stav98/UrsaRobotics_SmartHome/README.md

<H1><a href="https://stav98.github.io/UrsaRobotics/" target="_blank">Για φωτογραφίες με τα στάδια της κατασκευής, περιγραφή λειτουργίας, video και τεκμηρίωση, ακολουθήστε το Link ...</a></H1>

**Ομάδα:** Ursa Robotics<br/>
**Σχολείο:** 1ο ΕΠΑ.Λ. Πρέβεζας<br/>
**Τίτλος έργου:** Έξυπνο Σπίτι Ανοιχτών Τεχνολογιών<br/> 

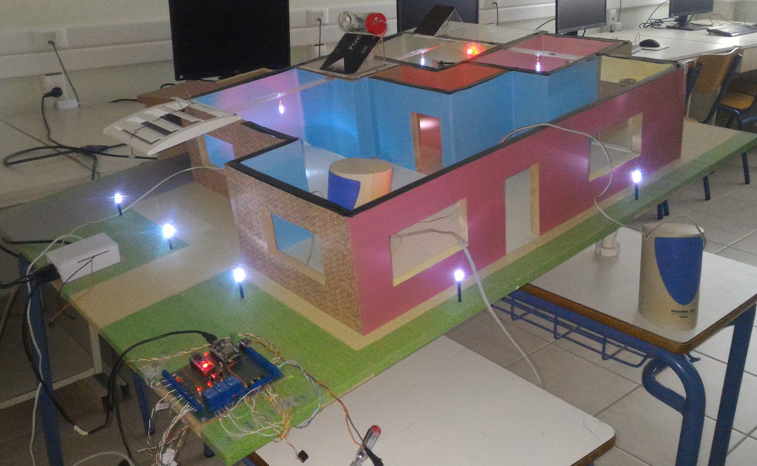
[picture p1: images/maketa_teliki.jpg]


<a href="https://www.youtube.com/embed/EgXMZQicLHs">Το video της τελικής παρουσίασης</a>

<a href="https://github.com/stav98/UrsaRobotics_SmartHome/blob/master/protasi-specs.md" target="_blank">Η αρχική πρόταση και οι προδιαγραφές πριν την υλοποίηση.</a>
