stav98/UrsaRobotics_SmartHome/hardware/README.md

Εδώ υπάρχουν τα θεωρητικά κυκλώματα καθώς και ο τρόπος συνδεσμολογίας των συσκευών στη μακέτα.
Τα σχέδια δημιουργήθηκαν με το KiCad 4.0.5.
