stav98/UrsaRobotics_SmartHome/arduino/README.md

Αυτός είναι ο κώδικας που ανεβαίνει στο Arduino Nano. Εμείς τον μεταγλωττίσαμε με το IDE 1.8.9 για Raspberry (ARM 32bit) και για Debian i386. Στις beta εκδόσεις 2.xx μεταγλωττίζεται με κάποιο λάθος και δεν λειτουργεί σωστά η απάντηση από τον slave 2 συνεχόμενων bytes.
Δεν απαιτείται κάποια extra βιβλιοθήκη.
