stav98/UrsaRobotics_SmartHome/node-red/src/README.md

Το αρχείο flow-dd-mm-yy.txt είναι αυτό που πρέπει να γίνει import στο Node-Red. Προσοχή απαιτείται εγκατάσταση του UI.
Ακόμη είναι σε πολύ απλή μορφή και πρόκειται να κάνουμε πολλές βελτιώσεις.

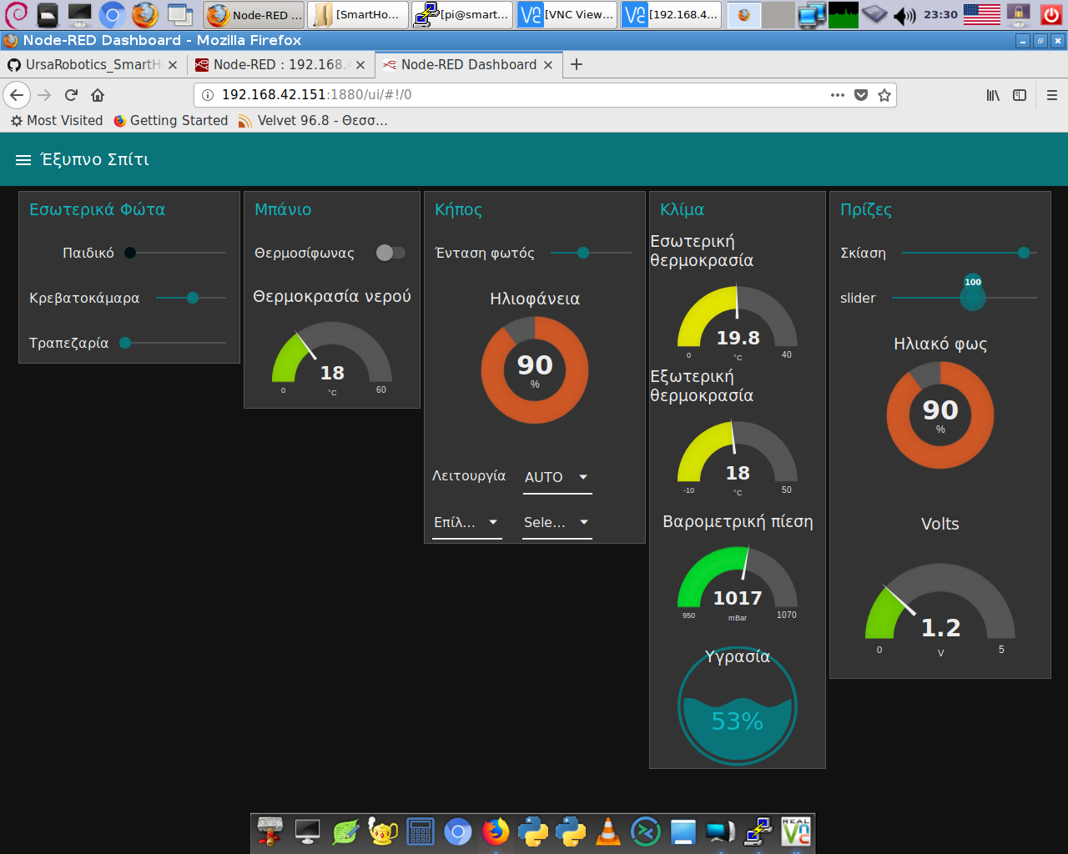
[picture p2: node-red/src/ui1.png]


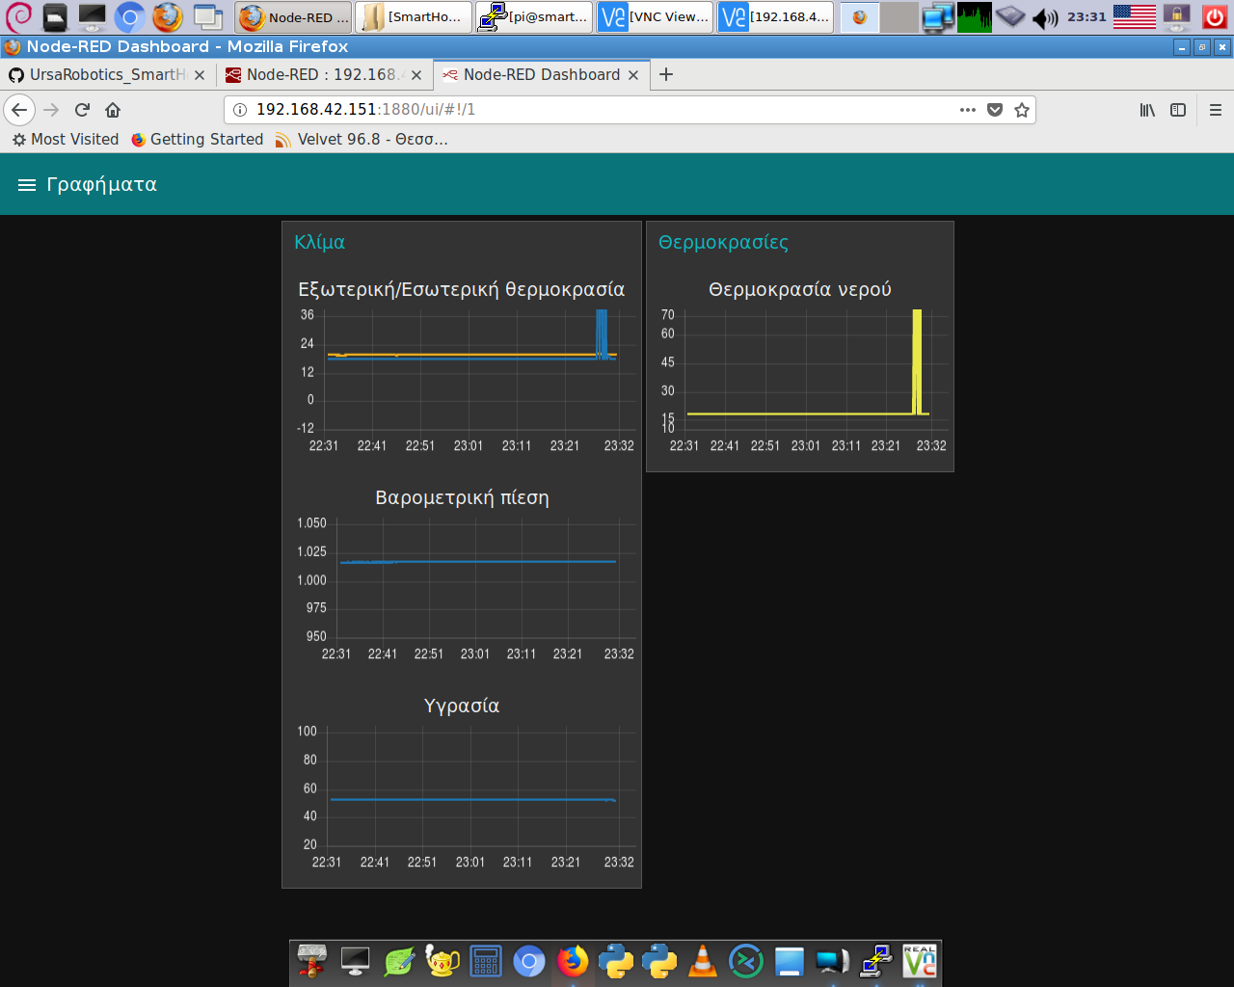
[picture p3: node-red/src/ui2.png]


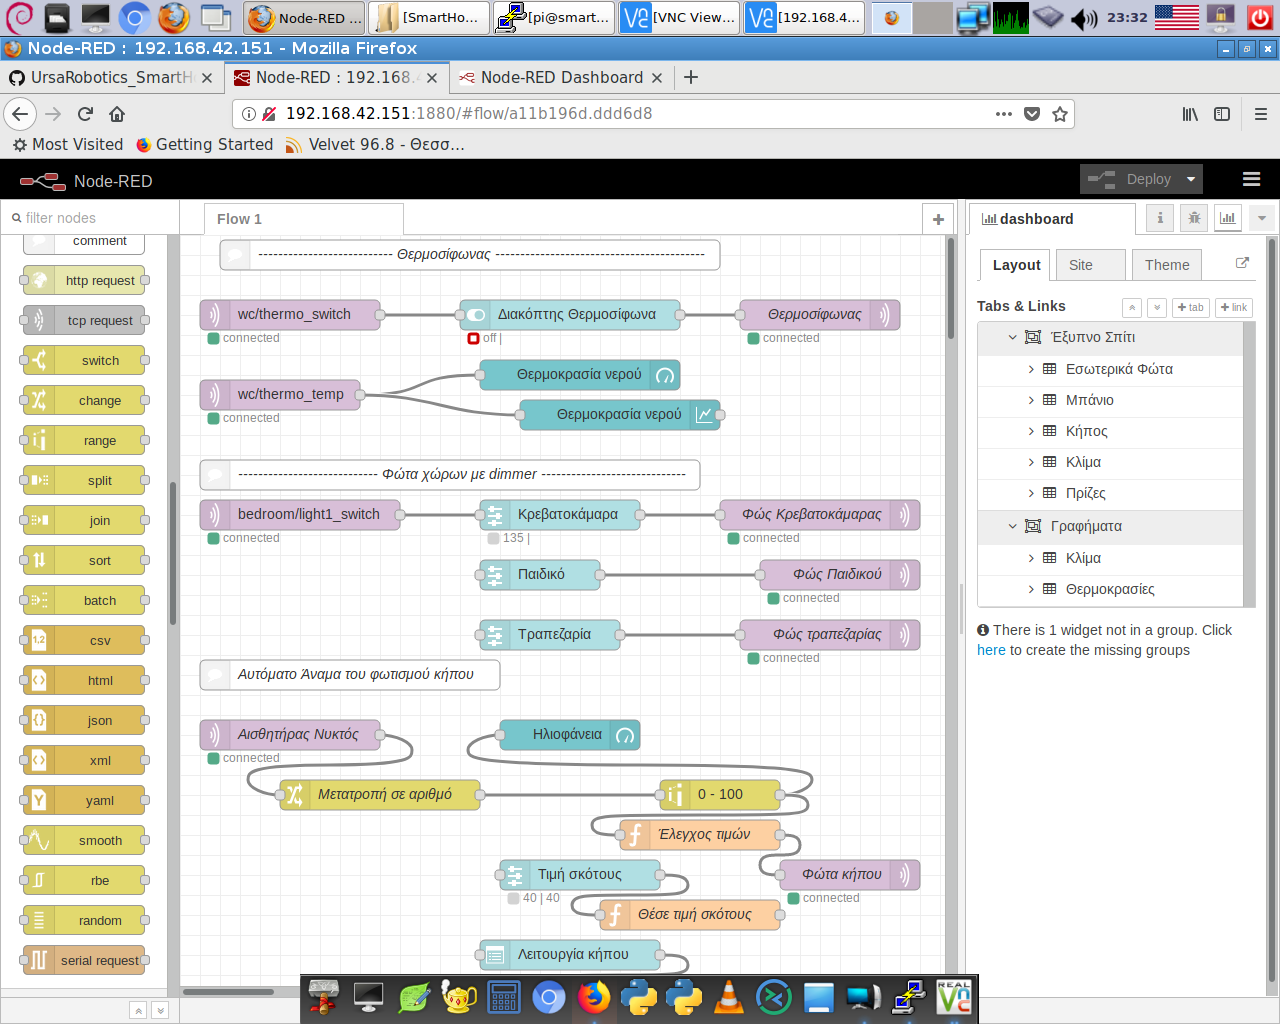
[picture p4: node-red/src/flow1.png]
