stav98/UrsaRobotics_SmartHome/Schematics.md

Το σχέδιο της μακέτας
=====================
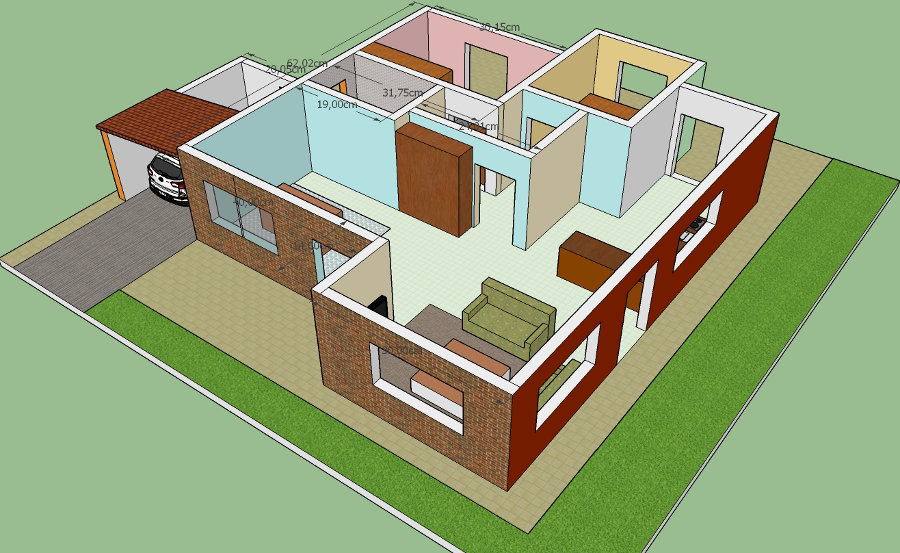
[picture p6: images/maketa_3d.jpg]


Οι θέσεις των εξαρτημάτων στη μακέτα
====================================
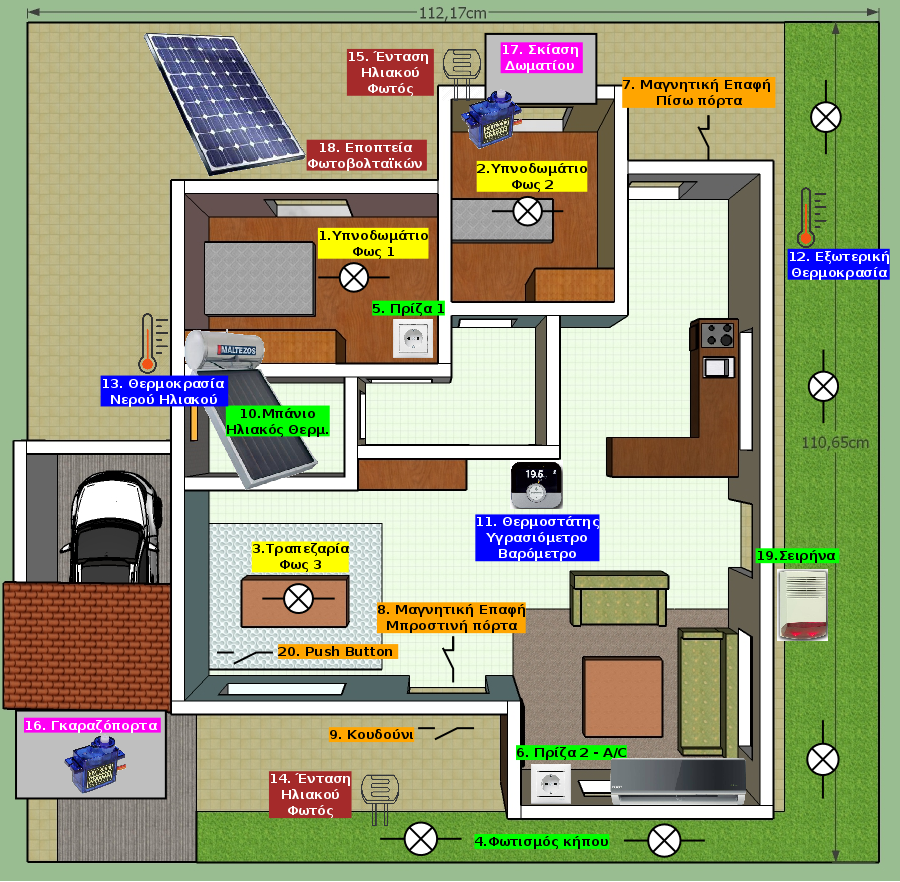
[picture p7: images/maketa_nodim_katopsi1.png]


Οι τύποι των σημάτων

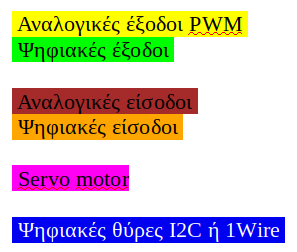
[picture p8: images/signal_types.png]


Συνδεσμολογία ακίδων στο Arduino mini

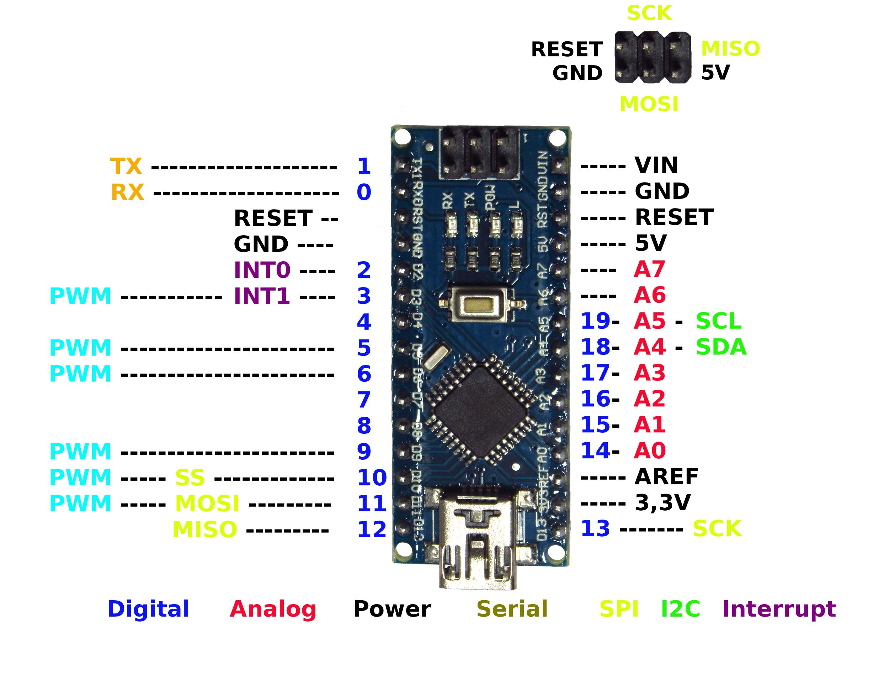
[picture p9: images/ArduinoNano_Pinout.jpg]


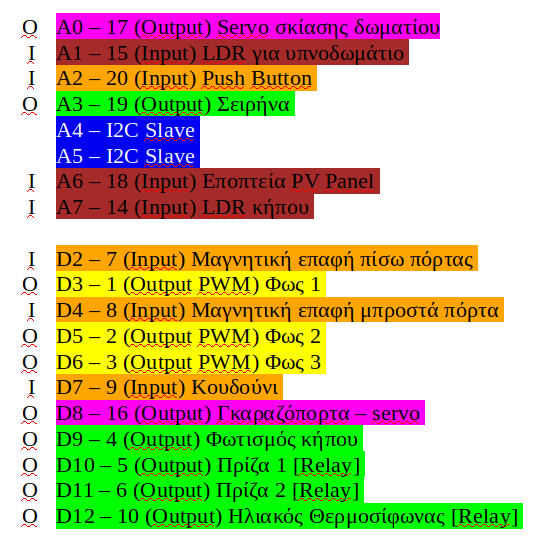
[picture p10: images/arduino_pin_connections.png]
