stav98/UrsaRobotics_SmartHome/documentation/README.md

Εδώ υπάρχουν έγγραφα όπως αρχεία περιγραφής, φύλλα εργασίας και παρουσιάσεις.

Τα διαγράμματα με επέκταση .xml έχουν δημιουργηθεί στο online σχεδιαστικό draw.io.

Στο αρχείο maketa-3d.zip υπάρχει το τρισδιάστατο μοντέλο της μακέτας φτιαγμένο σε Sketchup 2016.
