stav98/UrsaRobotics_SmartHome/python/README.md

Εδώ υπάρχει ο κώδικας για χρήση φωνητικών εντολών.
