stav98/UrsaRobotics_SmartHome/micropython/src/README.md

Τα αρχεία με επέκταση .py πρέπει να ανέβουν στο ESP8266 -  Node MCU. 
Το αρχείο upload το χρησιμοποιούμε για αυτοματοποιημένο Upload μέσα από το Geany (Raspbian) πατώντας Shift+F8.
