stav98/UrsaRobotics_SmartHome/documentation/software_interconnection.png

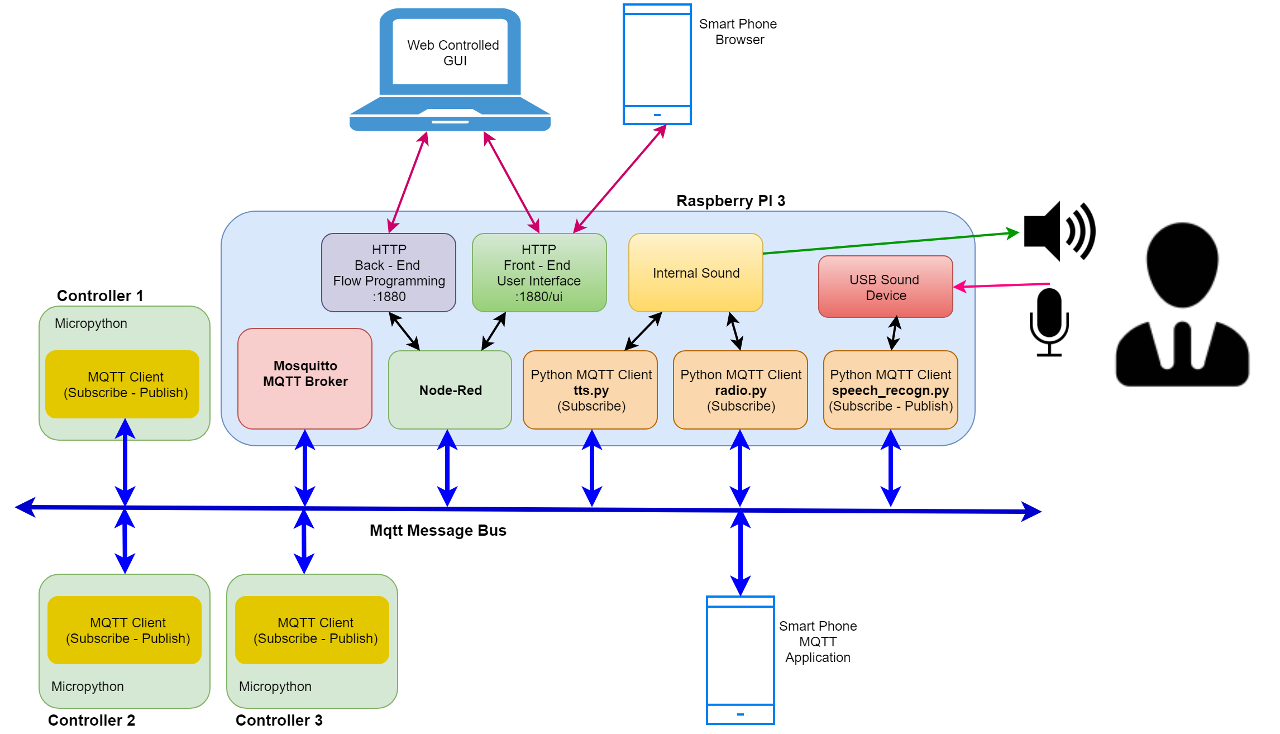
documentation/software_interconnection.png
