stav98/UrsaRobotics_SmartHome/hardware/controller_ports.jpg

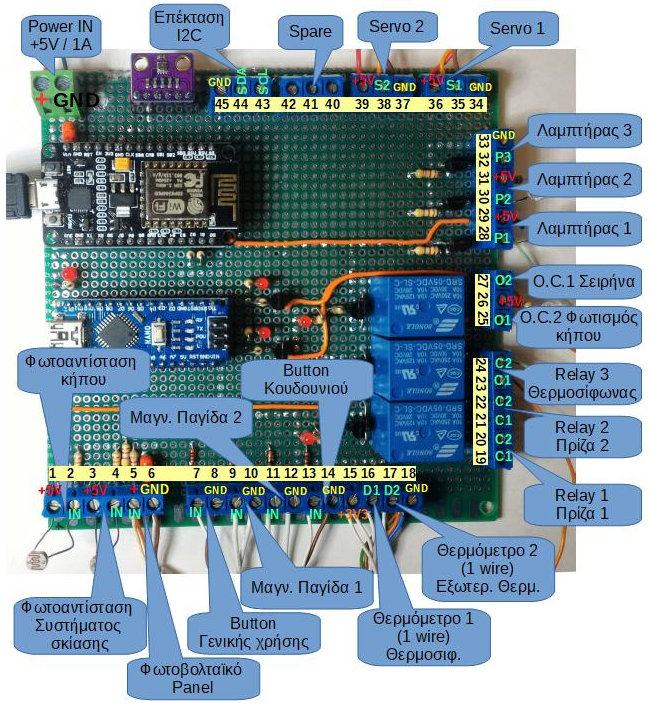
hardware/controller_ports.jpg
