stav98/UrsaRobotics_SmartHome/hardware/thermometer.jpg

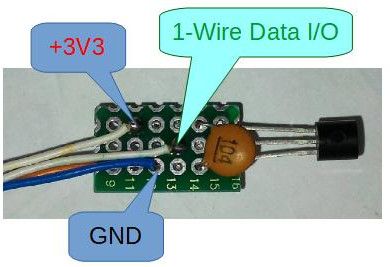
hardware/thermometer.jpg
