stav98/UrsaRobotics_SmartHome/Parts_Table.md

Πίνακας υλικών
======================

|Α/Α| Τύπος	 | Ποσότητα | Τιμή (€) |Προμηθευτής - Link εξαρτ.| Συνολική τιμή (€)| 
|:--:|---|:---:|:---:|:---:|:---:|
| 1	| Raspberry Pi 3 Model B+  |1|46,90|[e-shop](https://www.e-shop.gr/modmypi-mmp-1153-raspberry-pi-3-model-b--p-PER.818063)|46,90|
| 2	| Τροφοδοτικό για Raspberry|1|8,90|[e-shop](https://www.e-shop.gr/raspberry-pi-3-official-power-supply-uk-and-eu-51v-25a-black-p-PER.817963)|8,90|
| 3	| Κάρτα μνήμης 32Gb για Raspberry|1|6,85|[e-shop](https://www.e-shop.gr/samsung-mb-mc32ga-eu-evo-plus-32gb-micro-sdhc-u1-class-10-adapter-p-PER.577044)|6,85|
| 4	| Θήκη για Raspberry|1|3,60|[Grobotronics](https://grobotronics.com/raspberry-pi-2-3-square-case-transparent.html)|3,60|
| 5	| Node MCU|1|8,99|[Cableworks](https://www.cableworks.gr/ilektronika/arduino-and-microcontrollers/microcontrollers/esp8266/esp8266-nodemcu-with-cp2102-wifi-internet-development-board/)|8,99|
| 6	| Arduino Nano|1|5,00|[Cableworks](https://www.cableworks.gr/ilektronika/arduino-and-microcontrollers/microcontrollers/compatible-boards/arduino-nano-v3.0-w-atmega328p-with-mini-usb-cable-unsoldered/)|5,00|
| 7	| LED 5mm λευκά πακέτο των 10|1|0,40|[Cableworks](https://www.cableworks.gr/ilektronika/arduino-and-microcontrollers/components-and-ic/leds/5mm/10pcs-super-bright-5mm-white-leds/)|0,40|
| 8	| Relays 5V|3|0,81|[Cableworks](https://www.cableworks.gr/ilektronika/arduino-and-microcontrollers/components-and-ic/songle-relay-5v-5-pin-for-arduino-srd-05vdc-sl-c/)|2,43|
| 9	| Αισθητήρας BME280|1|8,49|[Cableworks](https://www.cableworks.gr/ilektronika/arduino-and-microcontrollers/sensors/temperature/bme280-high-precision-barometric-pressure-and-humidity-sensor-for-arduino-gy-b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)|8,49|
|10	| Κινητήρες Servo MG90|2|5,00|[Cableworks](https://www.cableworks.gr/ilektronika/arduino-and-microcontrollers/motors/servo/mg90s-micro-metal-gear-9g-servo-for-arduino-rc-180-degrees/)|10,00|
|11	| Θερμόμετρο 1wire DS18B20|4|1,80|[Cableworks](https://www.cableworks.gr/ilektronika/arduino-and-microcontrollers/sensors/temperature/ds18b20-18b20-to-92-thermometer-temperature-sensor-for-arduino-dallas/)|7,20|
|12	| Transistors NPN BC547|10|0,05|[Grobotronics](https://grobotronics.com/transistor-npn-50v-0.1a-bc547.html)|0,50|
|13	| Πλακέτα διάτρητη συνδέσεων perfboard|2|3,99|[Cableworks](https://www.cableworks.gr/ilektronika/arduino-and-microcontrollers/prototyping/pcb/prototype-12x18cm-pcb-double-side-bread-board-fr4/)|7,98|
|14 | Μαγνητικές επαφές |4|1,98|[Cableworks](https://www.cableworks.gr/systimata-asfaleias/synagermoi/magnitikes-epafes/aleph-1561g-gray/)|7,92|
|15 | Διάφορα εξαρτήματα (Αντιστάτες-πυκνωτές-καλώδια-pinheads)| |15,00|\*|15,00|
|16 | Υλικά μακέτας (Ξύλα, κόντρα πλακέ, βίδες)||45,00|\*|45,00|

\* Τα υλικά με Α/Α 15 και 16 θα τα προμηθευτούμε εμείς με έξοδα του σχολείου.

Συνολικό κόστος υλικών με Φ.Π.Α. πλην των Α/Α: 15 & 16 = **125,16€**

Συνολικό κόστος : **185€**
