stav98/UrsaRobotics_SmartHome/documentation/controller_layouts.pdf

## Node MCU

## Αισθητήρας

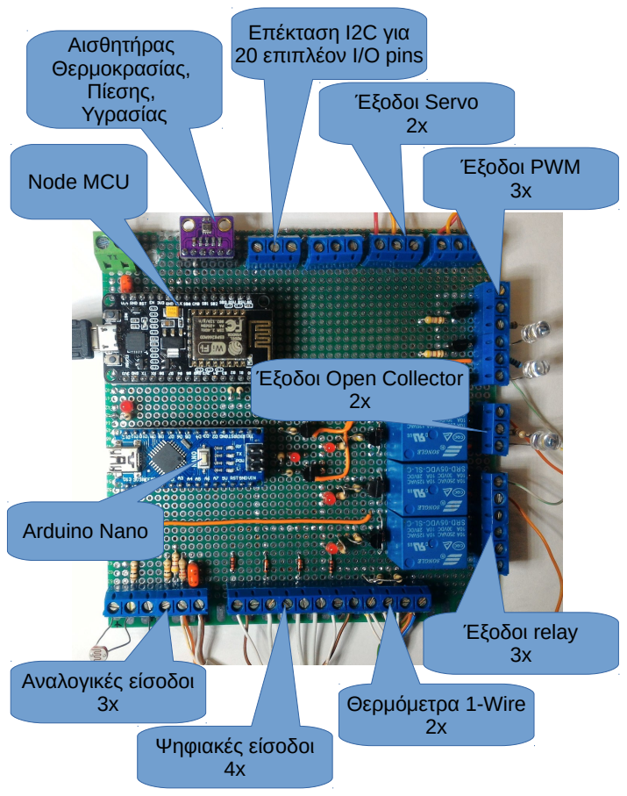
[picture p39: page 1]
Θερμοκρασίας, Πίεσης, Υγρασίας; Arduino Nano; Αναλογικές είσοδοι 3x; Ψηφιακές είσοδοι 4x; Θερμόμετρα 1-Wire 2x; Έξοδοι relay 3x; Έξοδοι Servo 2x; Έξοδοι PWM 3x; Επέκταση I2C για 20 επιπλέον I/O pins

Έξοδοι Open Collector

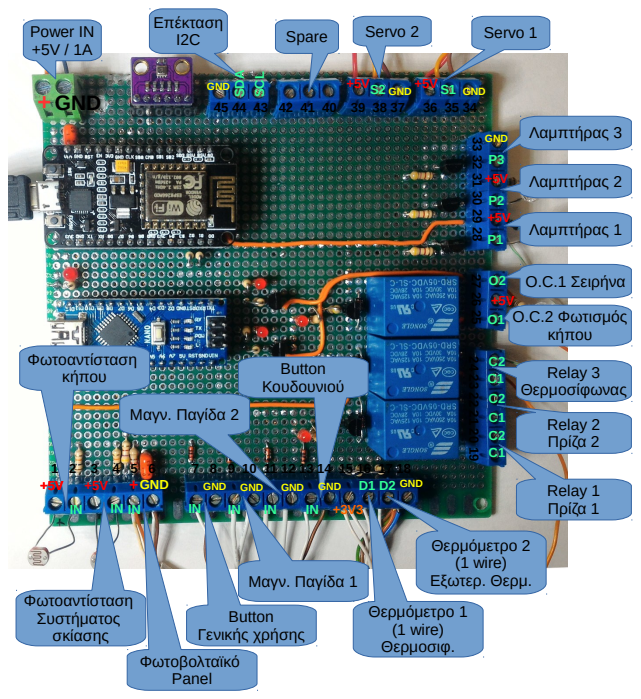
[picture p40: page 2]
Φωτοαντίσταση κήπου; Φωτοαντίσταση Συστήματος σκίασης; Φωτοβολταϊκό Panel; +GND; Power IN; Spare; + GND; Επέκταση; Servo 2; Servo 1; Λαμπτήρας 3; Λαμπτήρας 2; Λαμπτήρας 1; O.C.1 Σειρήνα; O.C.2 Φωτισμός κήπου; Relay 1 Πρίζα 1; Relay 2 Πρίζα 2; Relay 3 Θερμοσίφωνας; Button Γενικής χρήσης; Μαγν. Παγίδα 1; Μαγν. Παγίδα 2; Button Κουδουνιού; Θερμόμετρο 1 (1 wire) Θερμοσιφ.; Θερμόμετρο 2 (1 wire) Εξωτερ. Θερμ.; GND GND; GND

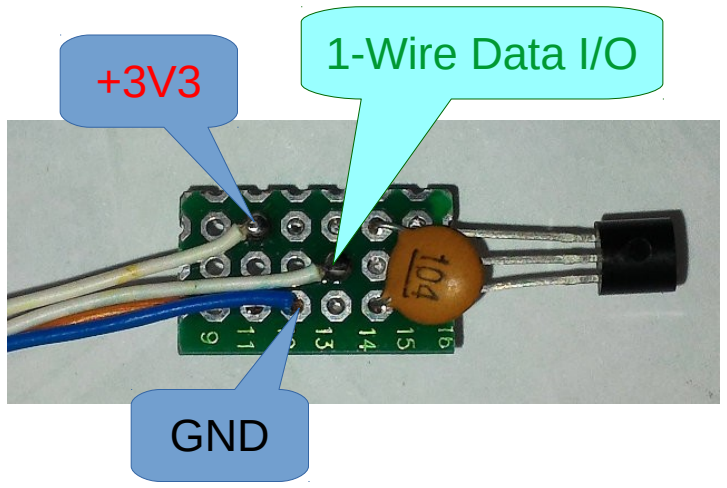
[picture p41: figure]
GND; 1-Wire Data I/O
