stav98/UrsaRobotics_SmartHome/hardware/smart_home_connections.pdf

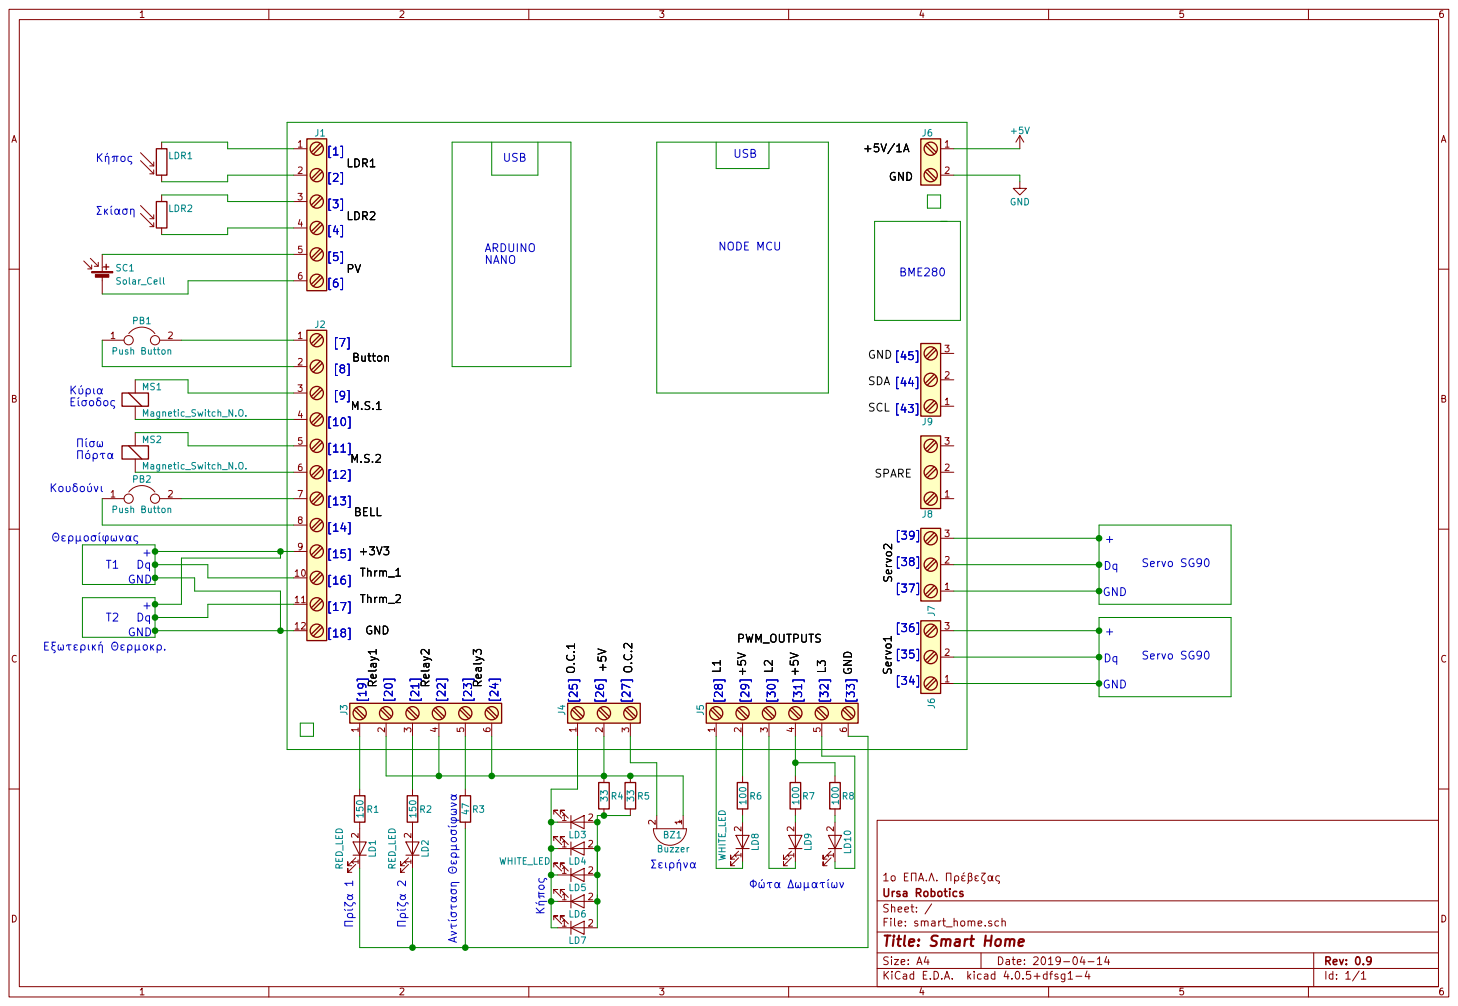
[picture p42: page 1]

Id: 1/1 Title: Smart Home
