stav98/UrsaRobotics_SmartHome/hardware/smart_home_schematic.pdf

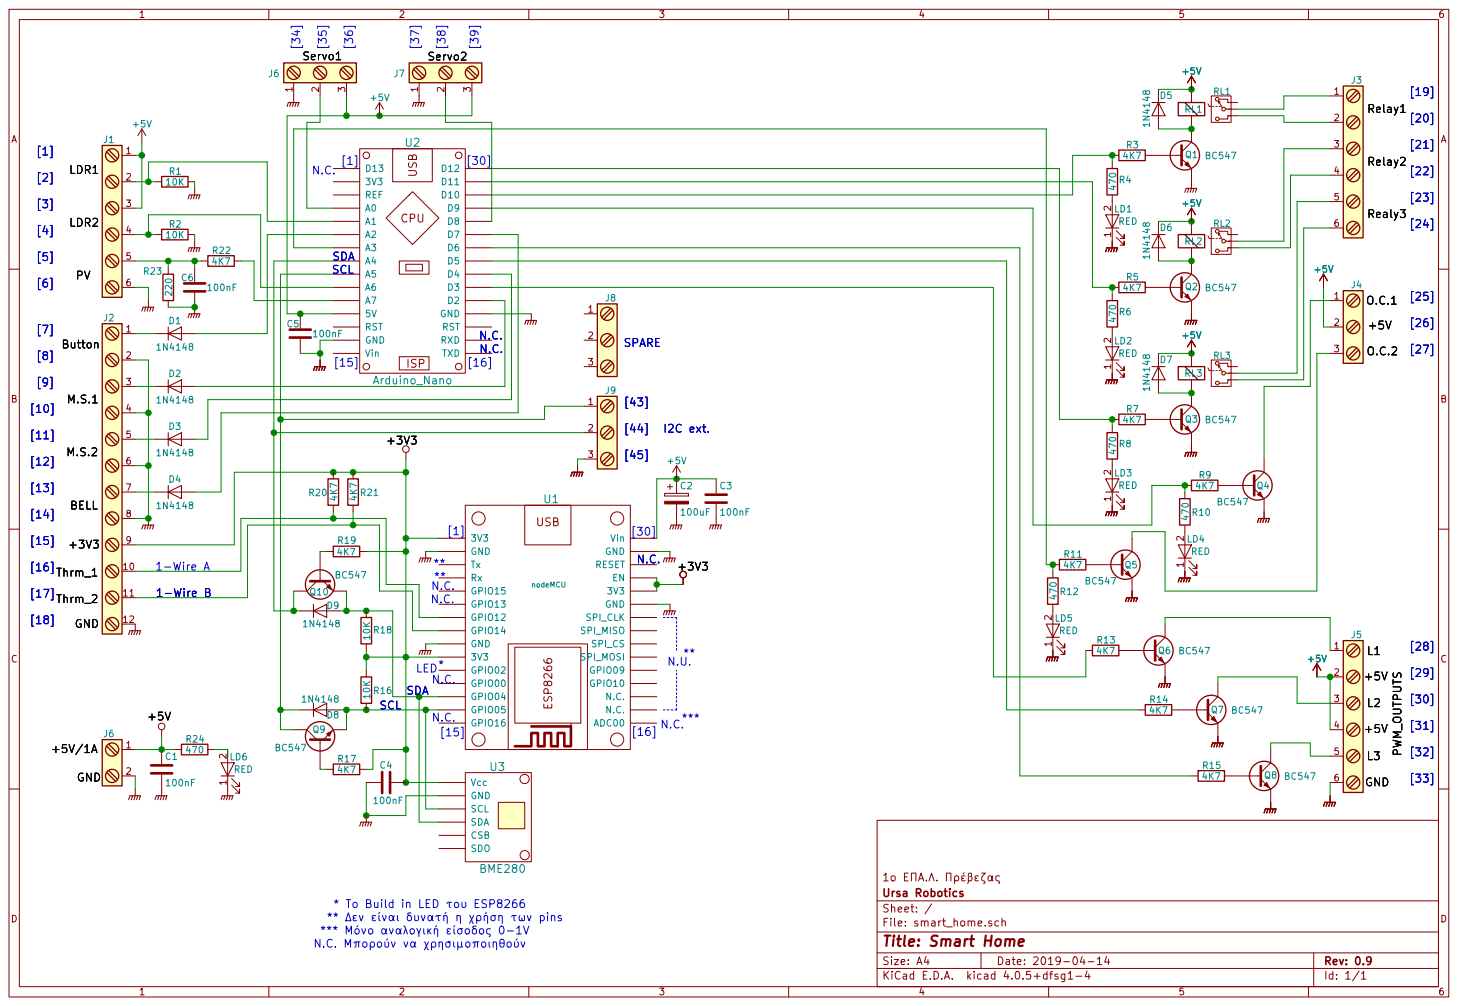
[picture p43: page 1]

File: smart_home.sch Sheet: / Ursa Robotics 1 ..

Id: 1/1 Title: Smart Home
