stav98/UrsaRobotics_SmartHome/hardware/kicad/smart_home_connections/smart_home.sch

## KiCad design hardware/kicad/smart_home_connections/smart_home.sch (2019-04-30)

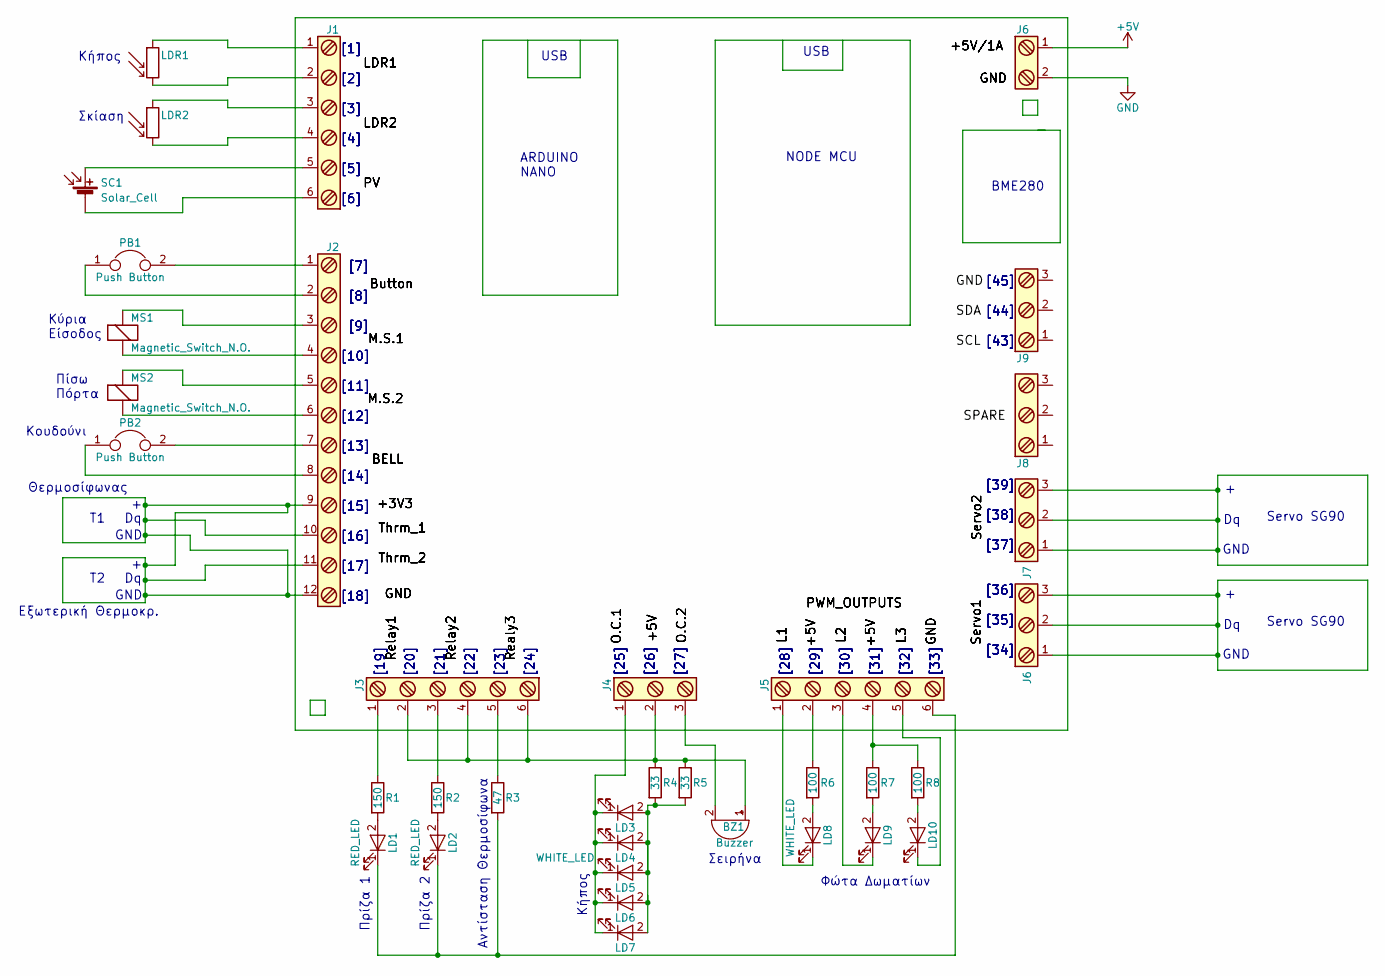
[picture p44: schematic smart_home.sch]

Parts:
BZ1: Buzzer
J1, J3, J5: Screw_Terminal_1x06
J2: Screw_Terminal_1x12
J4, J6, J7, J8, J9: Screw_Terminal_1x03
LD1, LD2: RED_LED
LD3, LD4, LD5, LD6, LD7, LD8, LD9, LD10: WHITE_LED
LDR1, LDR2: R_PHOTO
MS1, MS2: Magnetic_Switch_N.O.
PB1, PB2: Push Button
R1, R2: 150
R3: 47
R4, R5: 33
R6, R7, R8: 100
SC1: Solar_Cell

Connections:
+5V: J6.1
GND: J6.2
unnamed: BZ1.1 (-), J3.2, J3.4, J3.6, J4.2, R4.1, R5.1
unnamed: BZ1.2 (+), J4.3
unnamed: J1.1, LDR1.1
unnamed: J1.2, LDR1.2
unnamed: J1.3, LDR2.1
unnamed: J1.4, LDR2.2
unnamed: J1.5, SC1.1 (+)
unnamed: J1.6, SC1.2 (-)
unnamed: J2.1, PB1.2
unnamed: J2.2, PB1.1
unnamed: J2.3, MS1.1 (-)
unnamed: J2.4, MS1.2 (+)
unnamed: J2.5, MS2.1 (-)
unnamed: J2.6, MS2.2 (+)
unnamed: J2.7, PB2.2
unnamed: J2.8, PB2.1
unnamed: J2.9, J2.10, J2.11, J2.12
unnamed: J3.1, R1.1
unnamed: J3.3, R2.1
unnamed: J3.5, R3.1
unnamed: J4.1, LD3.1 (K), LD4.1 (K), LD5.1 (K), LD6.1 (K), LD7.1 (K)
unnamed: J5.1, LD8.1 (K)
unnamed: J5.2, R6.1
unnamed: J5.3, LD9.1 (K)
unnamed: J5.4, R7.1, R8.1
unnamed: J5.5, LD10.1 (K)
unnamed: J5.6, LD1.1 (K), LD2.1 (K), R3.2
unnamed: J6.1, J6.2, J6.3
unnamed: J7.1, J7.2, J7.3
unnamed: LD1.2 (A), R1.2
unnamed: LD2.2 (A), R2.2
unnamed: LD3.2 (A), LD4.2 (A), LD5.2 (A), LD6.2 (A), LD7.2 (A), R4.2, R5.2
unnamed: LD8.2 (A), R6.2
unnamed: LD9.2 (A), R7.2
unnamed: LD10.2 (A), R8.2

Notes on the sheet:
[1]
[2]
[3]
[4]
[5]
[6]
[7]
[8]
[9]
[10]
[11]
[12]
[13]
[14]
[15]
[16]
[17]
[18]
[36]
[35]
[34]
[39]
[38]
[37]
[19]
[20]
[21]
[22]
[23]
[24]
[25]
[26]
[27]
[28]
[29]
[30]
[31]
[32]
[33]
[43]
[44]
[45]
USB
ARDUINO NANO
NODE MCU
BME280
GND
Κήπος
Σκίαση
Κύρια Είσοδος
Πίσω Πόρτα
Κουδούνι
Θερμοσίφωνας
Εξωτερική Θερμοκρ.
Πρίζα 1
Πρίζα 2
Αντίσταση Θερμοσίφωνα
Σειρήνα
Φώτα Δωματίων
Servo SG90
